kloper/nicadpwr/board/nicadpwr.kicad_pcb

## KiCad design board/nicadpwr.kicad_pcb (2018-02-19)

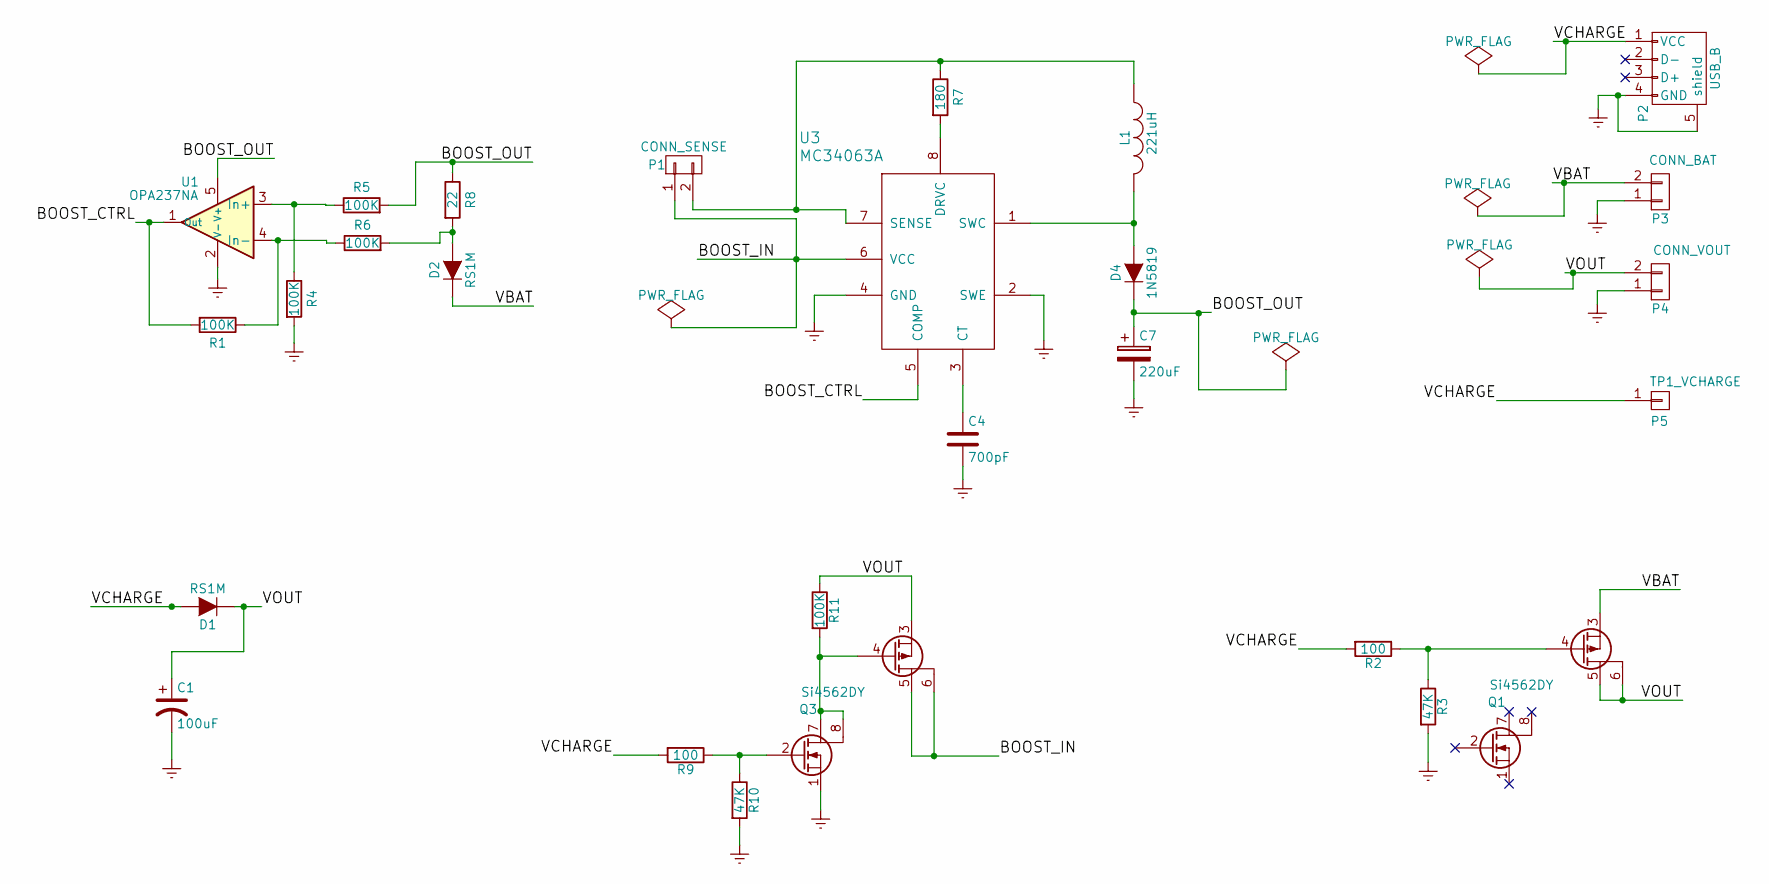
[picture p1: schematic nicadpwr.sch]

Parts:
C1: 100uF; CP_Tantalum_Case-U_EIA-6032-15_Hand
C4: 700pF; C_0805_HandSoldering
C7: 220uF; CP_Radial_D6.3mm_P2.50mm
D1, D2: RS1M; D_SMA_Handsoldering
D4: 1N5819; D_5W_P10.16mm_Horizontal
L1: 221uH; Inductor_Taiyo-Yuden_NR-80xx_HandSoldering
P1: CONN_SENSE; Socket_Strip_Straight_1x02_Pitch2.54mm
P2: USB_B; USB_Mini-B
P3: CONN_BAT; Socket_Strip_Straight_1x02_Pitch2.54mm
P4: CONN_VOUT; Socket_Strip_Straight_1x02_Pitch2.54mm
P5: TP1_VCHARGE; Pin_d0.9mm_L10.0mm_W2.4mm_FlatFork
Q1, Q3: Si4562DY; SOIC-8_3.9x4.9mm_Pitch1.27mm
R1, R4, R5, R6, R11: 100K; R_0805_HandSoldering
R2, R9: 100; R_0805_HandSoldering
R3, R10: 47K; R_0805_HandSoldering
R7: 180; R_0805_HandSoldering
R8: 22; R_0805_HandSoldering
U1: OPA237NA; SOT-23-5_HandSoldering
U3: MC34063A; MC34063A-DIP8

Connections:
/BOOST_CTRL: R1.2, U1.1 (Out), U3.5 (COMP)
/BOOST_IN: P1.1, Q3.5 (D2), Q3.6 (D2), U3.6 (VCC)
/BOOST_OUT: C7.1, D4.1 (K), R5.2, R8.1, U1.5 (V+)
/VBAT: D2.1 (K), P3.2, Q1.3 (S2)
/VCHARGE: D1.2 (A), P2.1 (VCC), P5.1, R2.2, R9.2
/VOUT: C1.1, D1.1 (K), P4.2, Q1.5 (D2), Q1.6 (D2), Q3.3 (S2), R11.1
Earth: C1.2, C4.2, C7.2, P2.4 (GND), P2.5 (shield), P3.1, P4.1, Q3.1 (S1), R3.2, R4.2, R10.2, U1.2 (V-), U3.2 (SWE), U3.4 (GND)
unnamed: C4.1, U3.3 (CT)
unnamed: D2.2 (A), R6.2, R8.2
unnamed: D4.2 (A), L1.2, U3.1 (SWC)
unnamed: L1.1, P1.2, R7.1, U3.7 (SENSE)
unnamed: Q1.4 (G2), R2.1, R3.1
unnamed: Q3.2 (G1), R9.1, R10.1
unnamed: Q3.4 (G2), Q3.7 (D1), Q3.8 (D1), R11.2
unnamed: R1.1, R6.1, U1.4 (In-)
unnamed: R4.1, R5.1, U1.3 (In+)
unnamed: R7.2, U3.8 (DRVC)

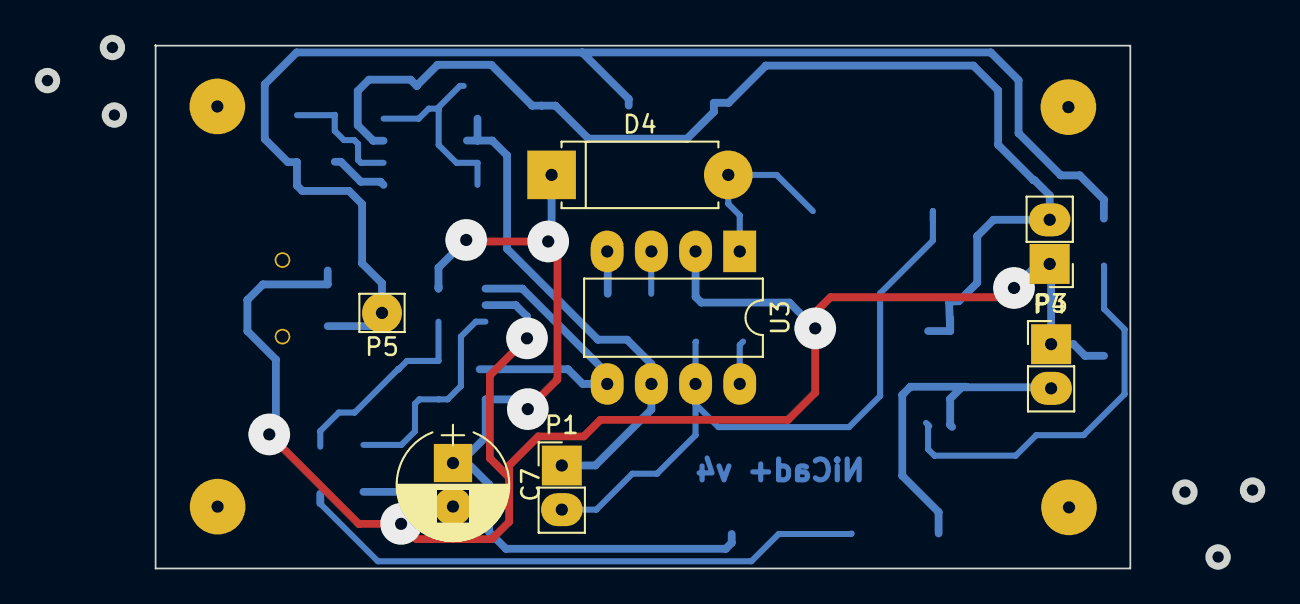
[picture p2: board nicadpwr.kicad_pcb from above]

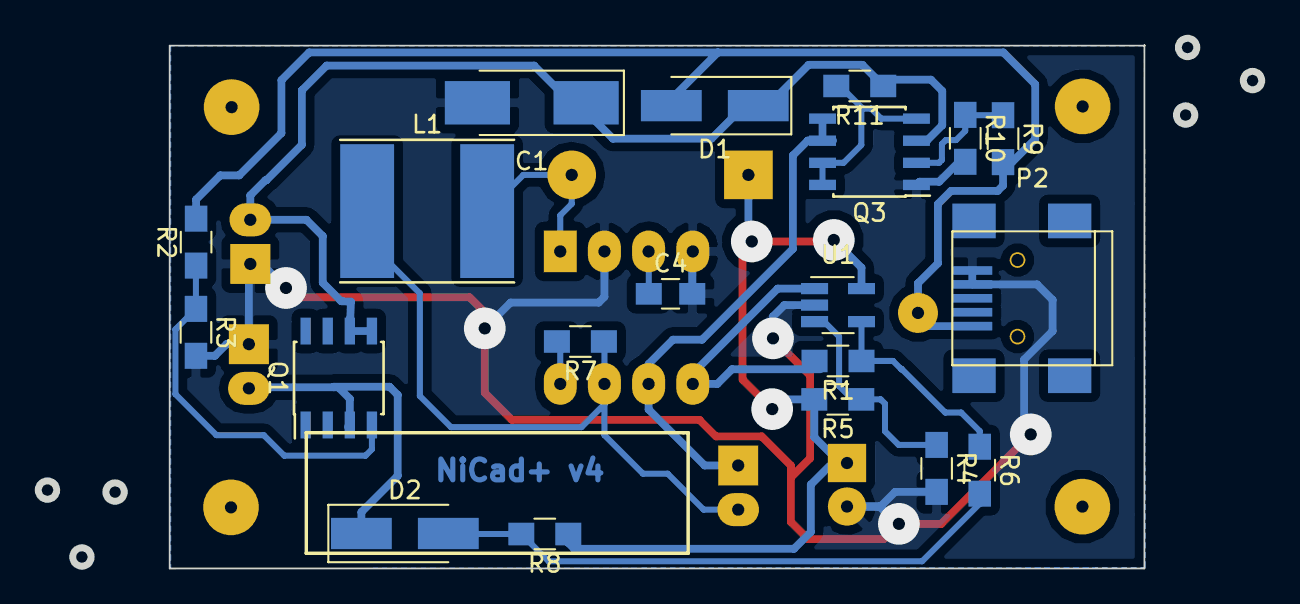
[picture p3: board nicadpwr.kicad_pcb from below]

Board: 2 copper layers, 56.1 x 30.1 mm, 27 parts (20 on the bottom side), 17 nets.
