kloper/nicadpwr/(commit log)

2018-01-02 Initial import of kicad project files
    NiCad is a charger and voltage step-up to 5V converter for
    battery pack of 4x 600mAH 1.2V Nickel Cadmium battery.
    [nicadpwr.kicad_pcb, nicadpwr.sch]
2018-01-10 Redesign of the board with fixes...
    1. The charging voltage is now 5V (suitable for charging from USB)
    The charging now is connected directly to boost converter and
    linear out and battery charger are connected to the boost output.
    The converter raises battery or charging voltage to 6.3 volt.
    2. Fixed problem with n-channel FET switch by using p-channel high
    side FET.
    3. The board is enlarged and made single copper layer.
    [nicadpwr.kicad_pcb, nicadpwr.sch]
2018-01-12 Place todos on schematics before v3
    [nicadpwr.sch]
2018-01-15 Minor changes
    [nicadpwr.sch]
2018-01-17 Rdesign of the board for v3
    The new version moves boost converter and charger out
    of the main path to be active only when charging.
    [nicadpwr.kicad_pcb, nicadpwr.sch]
2018-01-21 Fixes in schematic only to match working version:
    1. Boost capacitor was reduced to 220uF
    2. Control signal of the VBAT-VOUT switch was changed
    to VCHARGE instead of BOOST_OUT. The problem with the
    latter is discharge time of the boost cap.
    3. Led was removed since it was not populated in the working board.
    [nicadpwr.sch]
2018-02-19 Fix bugs to finaly get working board ...
    1. Upper rail for the sense opamp was set to +4V which holds its
    output under 1V. This is not enough for control of the MSP which
    is expected to be around 1.25V. Changed the upper rail to BOOST_OUT.
    2. Signal controlling Q1 battery switch was connected to BOOST_OUT.
    This works, but when charger is disconnected boost out capaccitor
    discharges relatively slowly and opens Q1 with considerable delay.
    Changed the Q1 control to VCHARGE instead.
    [nicadpwr.kicad_pcb, nicadpwr.sch]
